glenn-andrews/Sensor_Shield/Sensor_Shield.kicad_pcb

## KiCad design Sensor_Shield.kicad_pcb (2026-01-01)

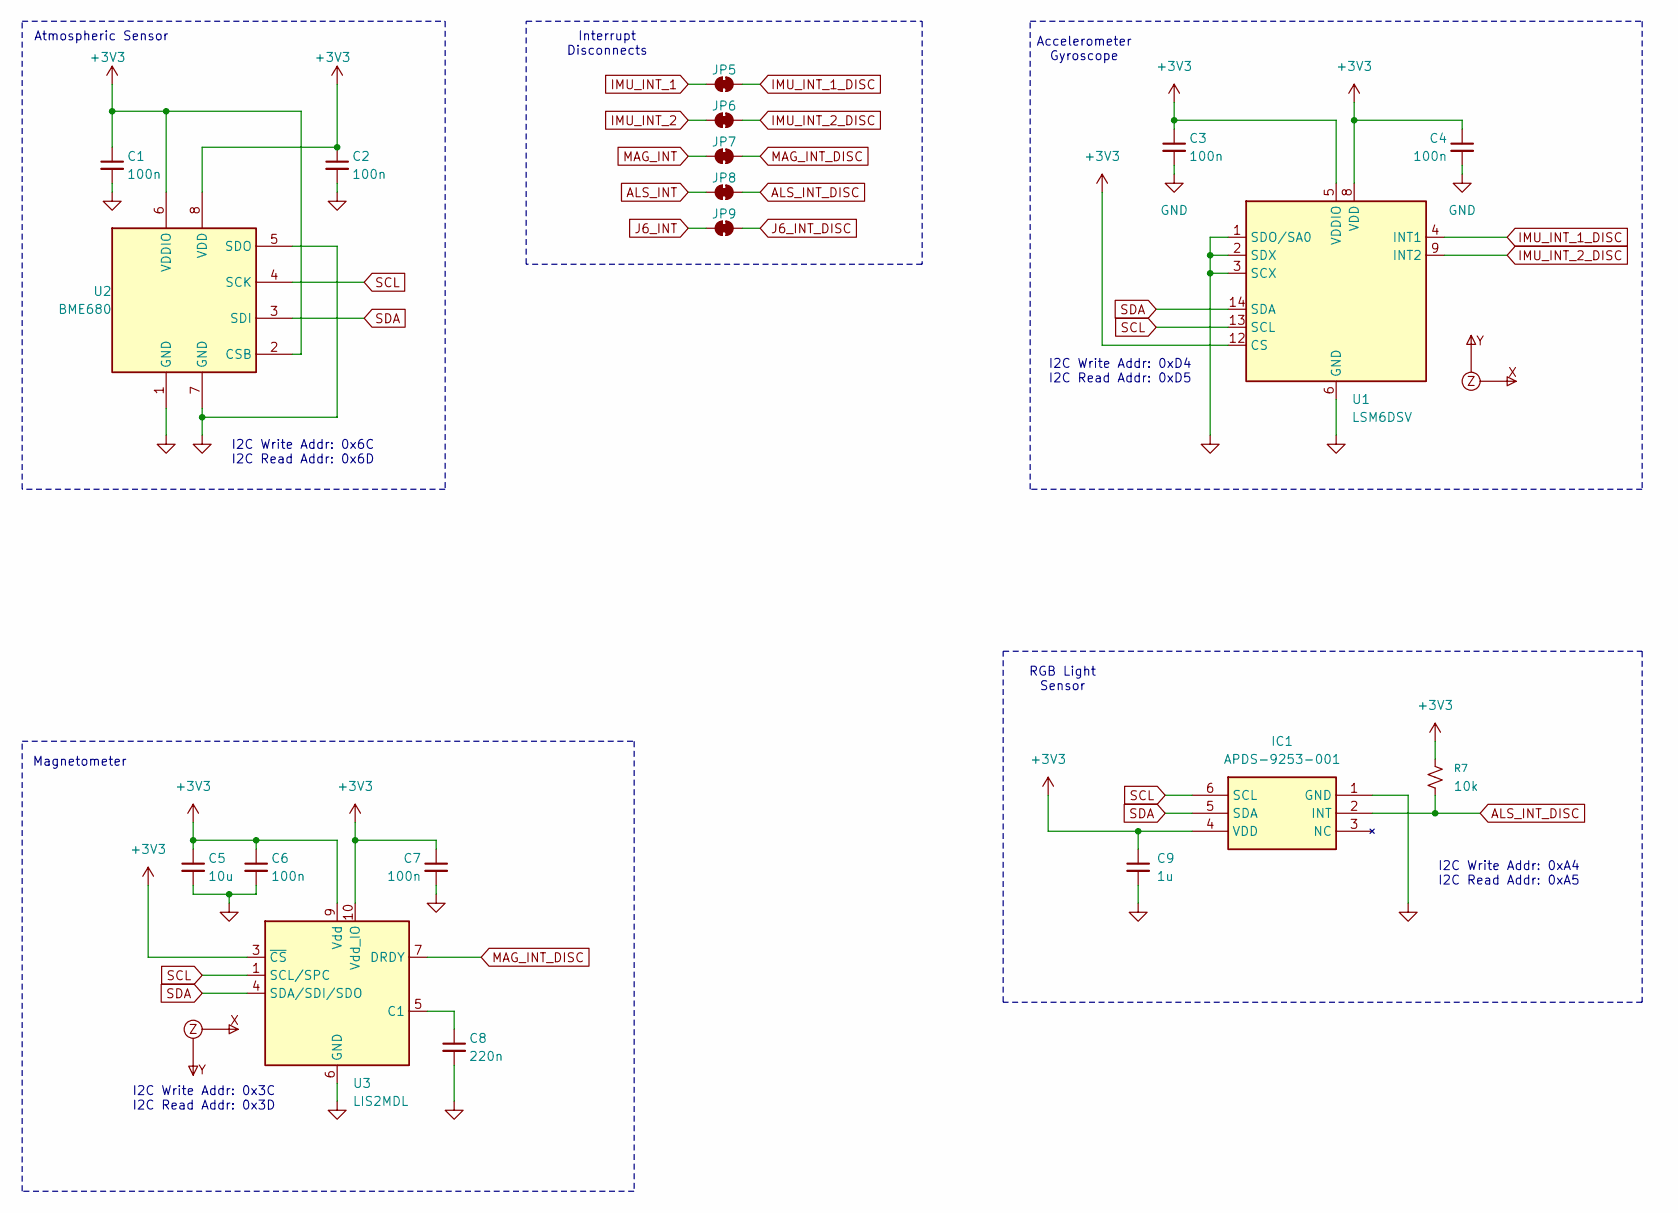
[picture p1: schematic sensors.kicad_sch, Sensor Shield]

Parts:
C1, C2, C3, C4, C6, C7: 100n; C_0402_1005Metric; Voltage 1kV; Tolerance 100%; MPN CL05A104KA5NNNC; Digi-Key PN 1276-1043-1-ND
C5: 10u; C_0805_2012Metric; Voltage 1kV; Tolerance 100%; MPN C0805C106K8PAC7210; Digi-Key PN 399-C0805C106K8PAC7210CT-ND
C8: 220n; C_0402_1005Metric; Voltage 1kV; Tolerance 100%; MPN CL05B224KO5NNNC; Digi-Key PN 1276-1176-1-ND
C9: 1u; C_0603_1608Metric; MPN C0603C105K4RACTU; Digi-Key PN 399-C0603C105K4RACTUCT-ND
IC1: APDS-9253-001; APDS9253001; Mouser Part Number 630-APDS-9253-001
JP5, JP6, JP7, JP8, JP9: Jumper_2_NC_Trace
R7: 10k; R_0402_1005Metric; MPN RC0402FR-0710KL; Digi-Key PN 311-10.0KLRCT-ND
U1: LSM6DSV; LGA-14_3x2.5mm_P0.5mm_LayoutBorder3x4y; MPN LSM6DSVTR; Digi-Key PN 497-LSM6DSVTRCT-ND
U2: BME680
U3: LIS2MDL; LGA-12_2x2mm_P0.5mm; MPN LIS2MDLTR; Digi-Key PN 497-17588-1-ND
U4: XYZ_Axes
U5: Mag_XYZ_Axes

Connections:
+3V3: C1.1, C2.1, C3.1, C4.1, C5.1, C6.1, C7.1, C9.1, IC1.4 (VDD), R7.2, U1.5 (VDDIO), U1.8 (VDD), U1.12 (CS), U2.2 (CSB), U2.6 (VDDIO), U2.8 (VDD), U3.3 (~CS), U3.9 (Vdd), U3.10 (Vdd_IO); also elsewhere on the board
ALS_INT: JP8.2 (B); also elsewhere on the board
ALS_INT_DISC: IC1.2 (INT), JP8.1 (A), R7.1
GND: C1.2, C2.2, C3.2, C4.2, C5.2, C6.2, C7.2, C8.2, C9.2, IC1.1 (GND), U1.1 (SDO/SA0), U1.2 (SDX), U1.3 (SCX), U1.6 (GND), U1.7 (GND), U2.1 (GND), U2.5 (SDO), U2.7 (GND), U3.6 (GND), U3.8 (GND); also elsewhere on the board
IMU_INT_1: JP5.2 (B); also elsewhere on the board
IMU_INT_1_DISC: JP5.1 (A), U1.4 (INT1)
IMU_INT_2: JP6.2 (B); also elsewhere on the board
IMU_INT_2_DISC: JP6.1 (A), U1.9 (INT2)
J6_INT: JP9.2 (B); also elsewhere on the board
J6_INT_DISC: JP9.1 (A); also elsewhere on the board
MAG_INT: JP7.2 (B); also elsewhere on the board
MAG_INT_DISC: JP7.1 (A), U3.7 (DRDY)
unnamed: C8.1, U3.5 (C1)
SCL: IC1.6 (SCL), U1.13 (SCL), U2.4 (SCK), U3.1 (SCL/SPC); also elsewhere on the board
SDA: IC1.5 (SDA), U1.14 (SDA), U2.3 (SDI), U3.4 (SDA/SDI/SDO); also elsewhere on the board

Notes on the sheet:
I2C Write Addr: 0xA4 I2C Read Addr: 0xA5
Accelerometer Gyroscope
I2C Write Addr: 0x3C I2C Read Addr: 0x3D
RGB Light Sensor
I2C Write Addr: 0x6C I2C Read Addr: 0x6D
I2C Write Addr: 0xD4 I2C Read Addr: 0xD5
Magnetometer
Atmospheric Sensor
Interrupt Disconnects

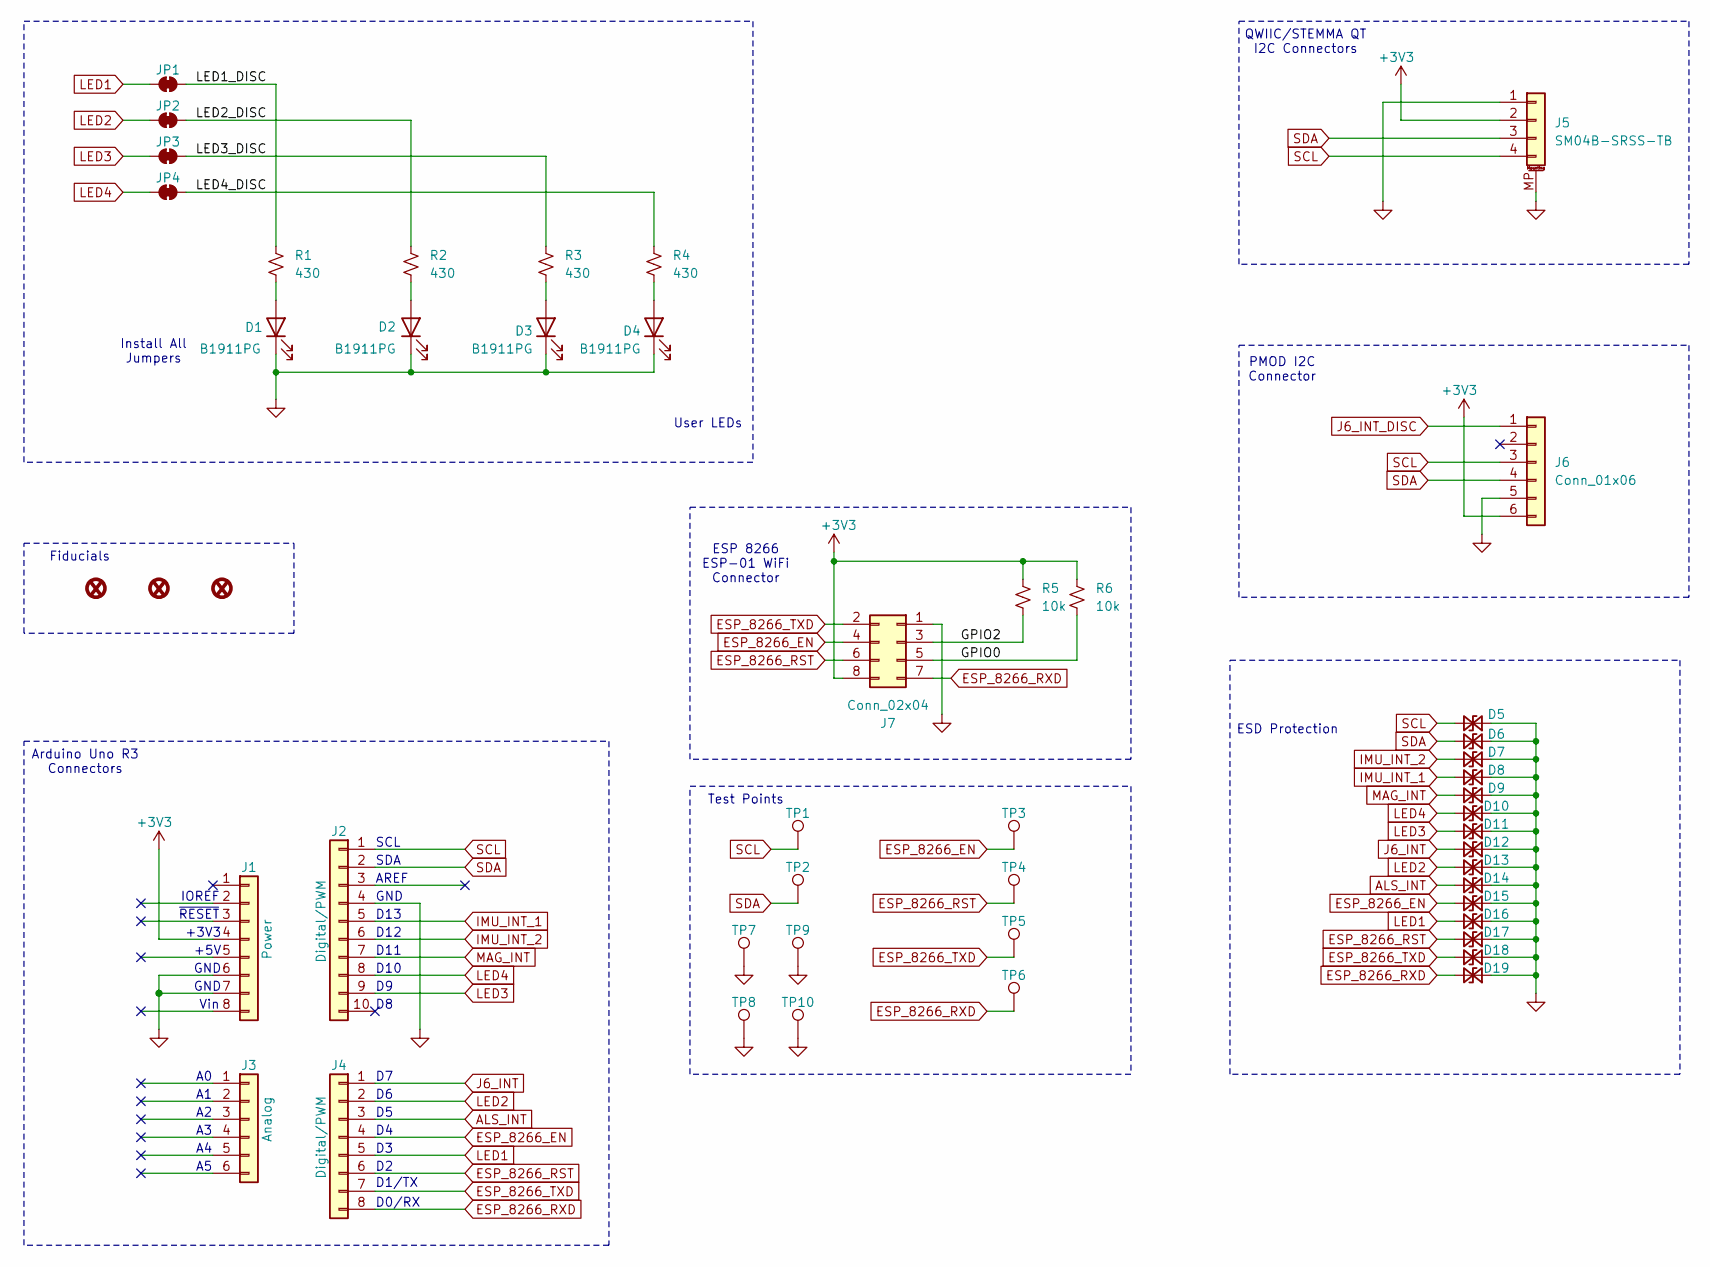
[picture p2: schematic connectors.kicad_sch, Sensor Shield]

Parts:
D1, D2, D3, D4: B1911PG; LED_0603_1608Metric; MPN B1911PG--20D000514U1930; Digi-Key PN 3147-B1911PG--20D000514U1930CT-ND
D5, D6, D7, D8, D9, D10, D11, D12, D13, D14, D15, D16, D17, D18, D19: D_TVS_Small; D_0402_1005Metric; MPN TPD1E10B06DPYR-EV; Digi-Key PN 5272-TPD1E10B06DPYR-EVCT-ND
FID1, FID2, FID3: Fiducial_0.5mm; Fiducial_0.5mm_Mask1mm
J1: Power; PinSocket_1x08_P2.54mm_Vertical; MPN 11417; Digi-Key PN 1568-11417-ND
J2: Digital/PWM; PinSocket_1x10_P2.54mm_Vertical; MPN 11417; Digi-Key PN 1568-11417-ND
J3: Analog; PinSocket_1x06_P2.54mm_Vertical; MPN 11417; Digi-Key PN 1568-11417-ND
J4: Digital/PWM; PinSocket_1x08_P2.54mm_Vertical; MPN 11417; Digi-Key PN 1568-11417-ND
J5: SM04B-SRSS-TB; JST_SH_SM04B-SRSS-TB_1x04-1MP_P1.00mm_Horizontal; MPN SM04B-SRSS-TB; Digi-Key PN 455-SM04B-SRSS-TBCT-ND
J6: Conn_01x06; PinSocket_1x06_P2.54mm_Horizontal_Flipped; MPN 613006143121; Digi-Key PN 732-613006143121-ND
J7: Conn_02x04; PinSocket_2x04_P2.54mm_Vertical; MPN 61300821821; Digi-Key PN 732-61300821821-ND
JP1, JP2, JP3, JP4: Jumper_2_NC_Trace
R1, R2, R3, R4: 430; R_0402_1005Metric; MPN RC0402FR-07430RL; Digi-Key PN 311-430LRCT-ND
R5, R6: 10k; R_0201_0603Metric; MPN RC0201FR-0710KL; Digi-Key PN 311-10.0KMCT-ND
TP1, TP2, TP3, TP4, TP5, TP6: 0.5mm; TestPoint-0.5mm
TP7, TP8, TP9, TP10: 1.25mm; TestPoint-1.0mm

Connections:
+3V3: J1.4, J5.2, J6.6, J7.8, R5.1, R6.1; also elsewhere on the board
/Connectors/GPIO0: J7.5, R6.2
/Connectors/GPIO2: J7.3, R5.2
/Connectors/LED1_DISC: JP1.2 (B), R1.1
/Connectors/LED2_DISC: JP2.2 (B), R2.1
/Connectors/LED3_DISC: JP3.2 (B), R3.1
/Connectors/LED4_DISC: JP4.2 (B), R4.1
ALS_INT: D14.2 (A2), J4.3; also elsewhere on the board
ESP_8266_EN: D15.2 (A2), J4.4, J7.4, TP3.1
ESP_8266_RST: D17.2 (A2), J4.6, J7.6, TP4.1
ESP_8266_RXD: D19.2 (A2), J4.8, J7.7, TP6.1
ESP_8266_TXD: D18.2 (A2), J4.7, J7.2, TP5.1
GND: D1.1 (K), D2.1 (K), D3.1 (K), D4.1 (K), D5.1 (A1), D6.1 (A1), D7.1 (A1), D8.1 (A1), D9.1 (A1), D10.1 (A1), D11.1 (A1), D12.1 (A1), D13.1 (A1), D14.1 (A1), D15.1 (A1), D16.1 (A1), D17.1 (A1), D18.1 (A1), D19.1 (A1), J1.6, J1.7, J2.4, J5.1, J5.MP (MountPin), J6.5, J7.1, TP7.1, TP8.1, TP9.1, TP10.1; also elsewhere on the board
IMU_INT_1: D8.2 (A2), J2.5; also elsewhere on the board
IMU_INT_2: D7.2 (A2), J2.6; also elsewhere on the board
J6_INT: D12.2 (A2), J4.1; also elsewhere on the board
J6_INT_DISC: J6.1; also elsewhere on the board
LED1: D16.2 (A2), J4.5, JP1.1 (A)
LED2: D13.2 (A2), J4.2, JP2.1 (A)
LED3: D11.2 (A2), J2.9, JP3.1 (A)
LED4: D10.2 (A2), J2.8, JP4.1 (A)
MAG_INT: D9.2 (A2), J2.7; also elsewhere on the board
unnamed: D1.2 (A), R1.2
unnamed: D2.2 (A), R2.2
unnamed: D3.2 (A), R3.2
unnamed: D4.2 (A), R4.2
SCL: D5.2 (A2), J2.1, J5.4, J6.3, TP1.1; also elsewhere on the board
SDA: D6.2 (A2), J2.2, J5.3, J6.4, TP2.1; also elsewhere on the board

Notes on the sheet:
QWIIC/STEMMA QT I2C Connectors
IOREF
GND
SDA
Fiducials
D11
SCL
ESD Protection
D12
Install All Jumpers
ESP 8266 ESP-01 WiFi Connector
PMOD I2C Connector
Vin
User LEDs
+5V
D0/RX
Test Points
AREF
Arduino Uno R3 Connectors
D13
+3V3
D1/TX
D10
~{RESET}

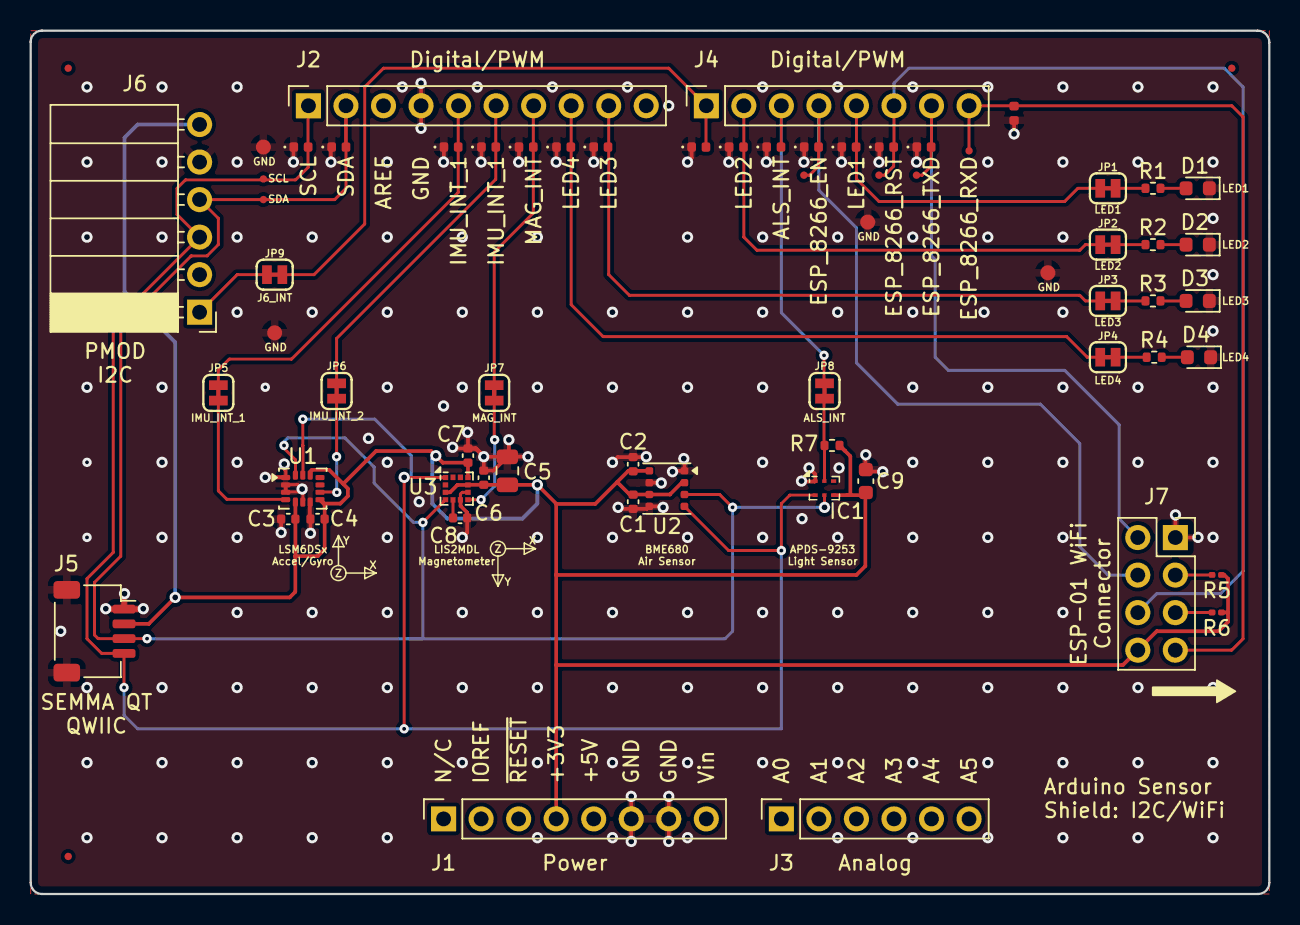
[picture p3: board Sensor_Shield.kicad_pcb from above]

Board: 2 copper layers, 83.8 x 58.4 mm, 70 parts (0 on the bottom side), 33 nets.
